2026-nuedc-d-land-air/DS-land-and-air/yolov5/runs/detect/exp6/1.jpeg

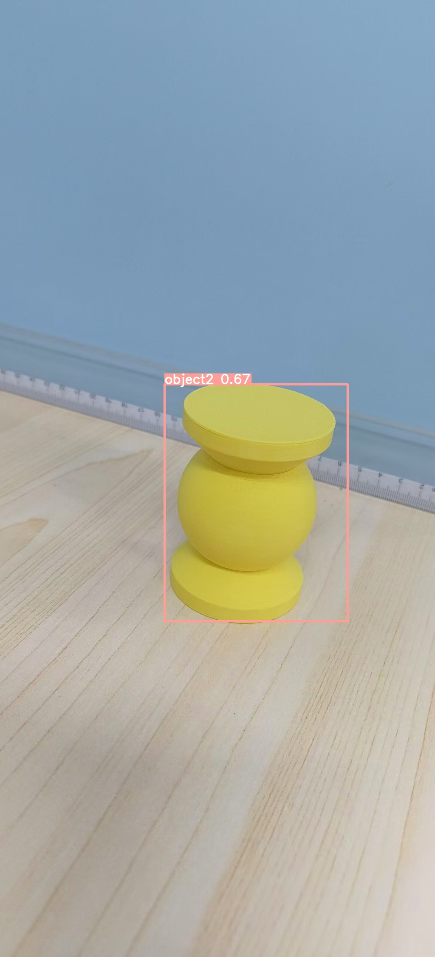
yolov5/runs/detect/exp6/1.jpeg
