2026-nuedc-d-land-air/DS-land-and-air/yolov5/runs/detect/exp12/compare.jpg

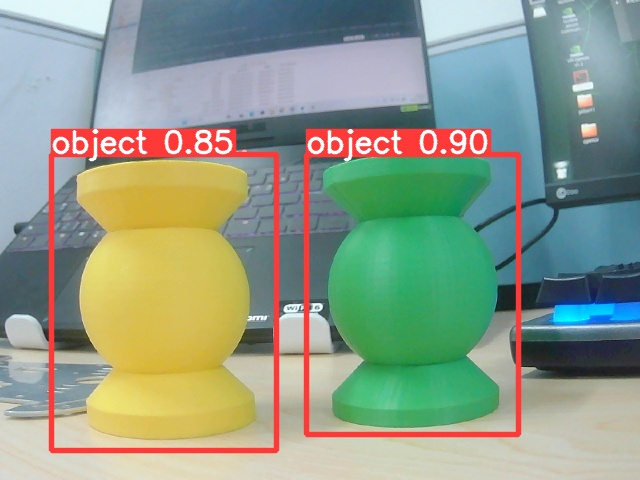
yolov5/runs/detect/exp12/compare.jpg
