2026-nuedc-d-land-air/DS-land-and-air/logs/gray_tracking_sync_20260730.md

# 灰度循迹接口纠正与重新测试检查点（2026-07-30）

## 有效硬件事实

用户提供的实物图确认模块为 Yahboom `YB-MVX05-V1.0`。排针丝印为
`5V / AD2 / AD1 / AD0 / OUT / GND`，并带有 X1--X8 的地址真值表。
模块内置 74HC4051 风格的数据选择器：MCU 输出三位地址，模块在 `OUT` 输出被选中
探头的数字值。蓝光版可用于白底黑线地图。

| 模块信号 | MCU 引脚 | 当前固件方向 |
| --- | --- | --- |
| `AD0` | `PC0` | GPIO 输出，地址 bit0 |
| `AD1` | `PC1` | GPIO 输出，地址 bit1 |
| `AD2` | `PC2` | GPIO 输出，地址 bit2 |
| `OUT` | `PG0` | GPIO 输入，所选头数字输出 |

地址 `000`--`111` 依次选择 X1--X8；固件将八个输出汇成 `raw_mask` 的 bit0--bit7。
以“所有探头都在白底”时的 `all_white_mask` 为基准，`active_mask = raw_mask XOR
all_white_mask`，因此不需要假定模块输出高/低代表黑线。

## 已废止的错误解释

此前将 `PC0/PC1/PC2` 配置成 ADC 输入是错误驱动。于是旧日志的 `adc0/adc1/adc2` 是
地址脚浮空/偏置读数，不是 X1--X8 的反射强度；其 x1/x2/x3 判定和任何 ADC 阈值均
不能用于循迹 PID。原始日志保留，仅作问题定位证据。

## 已完成的软件修正

- `bsp_gray_tracking.*`：改为 AD0/AD1/AD2 地址扫描 + PG0 数字读取；不用 `Delay_us()`
  破坏 SysTick 时间基。
- `app_gray_tracking_test.c`：输出 `raw_mask`、相对白底的 `active_mask` 与去抖
  `stable_mask`。
- `scripts/analyze_gray_mux_log.ps1`：输出逐头 `CHANNEL_SWITCH` 判定。
- `GrayTrackingDebug` 构建通过：FLASH `6400 B / 512 KB`，RAM `2008 B / 64 KB`；
  入口仍先调用 `MotorSafe_InitOff()`，前后 TB6612 关闭。

## 2026-07-30 mux8 全通道实机验收（完成）

已烧录安全的 `GrayTrackingDebug`（启动时仍执行 `MotorSafe_InitOff()`），通过 J-Link
CDC `COM13` 采集：`logs/gray_mux_retest_20260730-104601.log`。

- 全部探头白底、发送 `W` 后：`all_white_mask=0x00`；
- X1--X8 依次从白底移到黑线后，分析器均报告 `CHANNEL_SWITCH`；
- 一一对应关系为：`X1=0x01`、`X2=0x02`、`X3=0x04`、`X4=0x08`、
  `X5=0x10`、`X6=0x20`、`X7=0x40`、`X8=0x80`；
- X3 额外复测的黑线样本为 `0x04`，未出现 X4 的 `0x08`，未观察到相邻头串扰。

结论：`PC0/PC1/PC2 -> AD0/AD1/AD2`、`PG0 <- OUT`、X1--X8 地址顺序和蓝光模块的
白底黑线分辨能力均已实机确认。此前 ADC 记录仍只保留为错误定位归档。

## A 点全黑区域实测（2026-07-30 11:03）

用户确认当前整组探头位于 A 点（起点）的全黑区域。串口命令 `K` 采集黑色快照，日志
为 `logs/gray_mux_all_black_A_20260730-110324.log`：

- `cal_black`：`raw_mask=255`、`active_mask=255`、`stable_mask=255`；
- 随后约 4 s 连续 `sample` 均保持上述 `0xFF` 状态；
- 白底基准仍为 `0x00`，未被本次 `K` 命令改写。

全黑 A 点可以作为后续路线状态机的“位置确认”候选条件；根据当前任务规则，正式任务
启动仍必须由车上实体按键发起，不能由灰度全黑自动启动。

## 正常黑线居中零点实测（2026-07-30 11:06）

用户确认正常黑线居中时 X4 与 X5 同时触发。串口采集
`logs/gray_mux_center_x4_x5_20260730-110625.log` 中 24 条有效样本均为：

```text
raw_mask=24, active_mask=24, stable_mask=24   # 0x18 = X4 | X5
```

`0x18` 现作为灰度横向误差的零点掩码。该记录只证明“阵列索引居中”；尚未定义相对
车体左/右的误差正负，也尚未接入电机控制。

## 车体左/右误差符号实测（2026-07-30 11:15--11:16）

保持车头朝向后，用户按要求将正常黑线相对阵列从中心分别移向车体左、右侧：

| 位置 | 稳定掩码 | 样本 | 证据 |
| --- | --- | --- | --- |
| 车体左偏 | `0x08`（仅 X4） | 23/23 | `gray_mux_vehicle_left_x4_20260730-111544.log` |
| 居中 | `0x18`（X4+X5） | 24/24 | `gray_mux_center_x4_x5_20260730-110625.log` |
| 车体右偏 | `0x10`（仅 X5） | 23/23 | `gray_mux_vehicle_right_x5_20260730-111651.log` |

这确认 X1--X8 的阵列索引从车体左到右递增。安全诊断权重为
`-7/-5/-3/-1/+1/+3/+5/+7`；`err_x100` 的负值表示黑线在车体左，正值表示黑线在车体右。
仅灰度诊断输出允许使用此结论；还没有把误差接到任何电机输出。

## 误差诊断镜像烧录与串口回归（2026-07-30 11:19）

`GrayTrackingDebug` 已构建并通过 J-Link 烧录、逐段比较和复位运行：FLASH `7140 B /
512 KB`，RAM `2008 B / 64 KB`。`COM13` 回归日志
`logs/gray_error_diag_boot_20260730-111933.log` 已确认新字段输出：

```text
line_class,UNCAL,line_side,N/A,active_count,0,err_x100,0
```

烧录复位会清空 RAM 中的 `all_white_mask`，因此这条 `UNCAL` 记录是预期安全状态，
不是传感器故障。下一步必须先让八头同时位于白底并发送 `W`；校准后才可记录有效的
`LINE / LOST / A_MARK`、`line_side` 和 `err_x100`。电机保持关闭。

## 误差诊断三点回归（2026-07-30 11:20--11:22，完成）

新镜像复位后重新标定白底：`gray_error_diag_white_cal_20260730-112045.log`，
`all_white_mask=0x00`、`cal=1`。随后在同一白底基准下完成三点回归：

| 物理位置 | 实测稳定掩码 | 诊断输出 | 证据 |
| --- | --- | --- | --- |
| 正常居中 | `0x18`（X4+X5） | `LINE, CENTER, err_x100=0` | `gray_error_diag_center_20260730-112143.log` |
| 黑线在车体左 | `0x08`（X4） | `LINE, VEH_LEFT, err_x100=-100` | `gray_error_diag_vehicle_left_x4_20260730-112215.log` |
| 黑线在车体右 | `0x10`（X5） | `LINE, VEH_RIGHT, err_x100=100` | `gray_error_diag_vehicle_right_x5_20260730-112247.log` |

三组样本均持续约 4 s、无掩码跳变，证明 mux8 采样、3 次去抖、权重、中心零点和左右
符号在当前地图上闭合一致。允许把 `err_x100` 接入下一阶段的“仅计算控制量”循迹外环；
电机驱动输出仍必须保持断开，直到单独完成方向、限幅和失线保护测试。

## 后续受控步骤

1. 保持电机关闭，以实际安装朝向确认 X1--X8 的车体左/右方向，并把 `active_mask`
   转换为加权横向误差。
2. 先只输出误差、丢线和交叉线判定日志；确认误差正负后才接入低速循迹控制。
3. 速度闭环、陀螺仪修正和灰度外环必须按阶段叠加，不能跳过电机方向与误差符号验收。
