2026-nuedc-d-land-air/DS-land-and-air/yolov5/runs/detect/exp6/0.jpeg

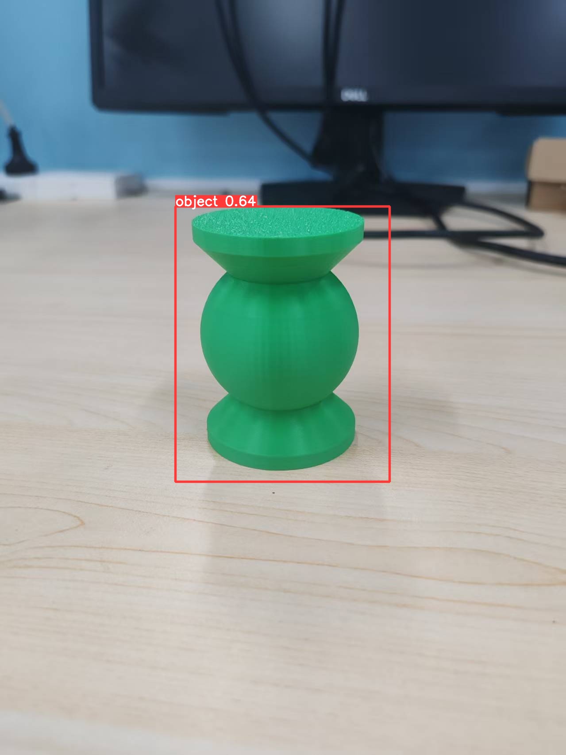
yolov5/runs/detect/exp6/0.jpeg
