2026-nuedc-d-land-air/DS-land-and-air/双臂小车/机械臂/爪子/爪子.SLDASM

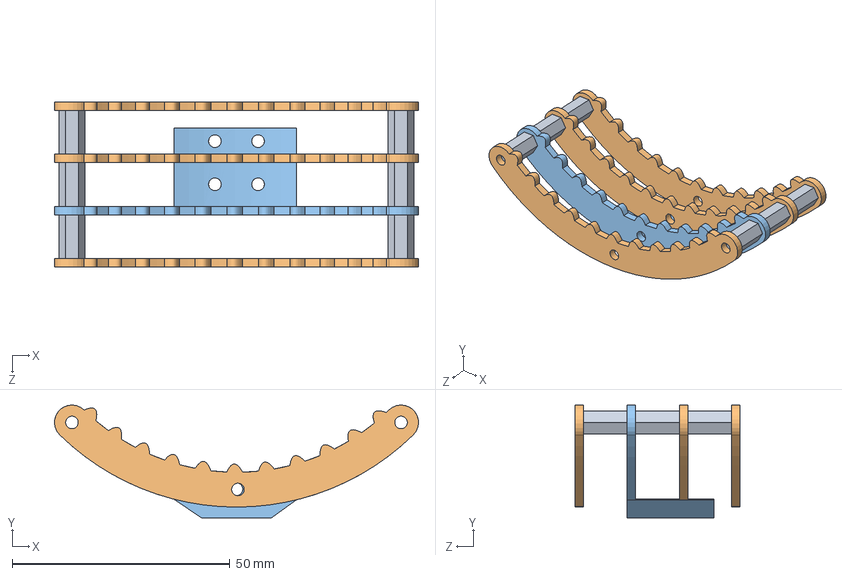
[picture p4: CAD file, 2026-07-15]
双臂小车/机械臂/爪子/爪子.SLDASM
83.6 x 25.9 x 38.0 mm
爪片连接
爪片 x 3
10mm铜柱 x 6
