2026-nuedc-d-land-air/DS-land-and-air/双臂小车/小车/小车基础模型.SLDASM

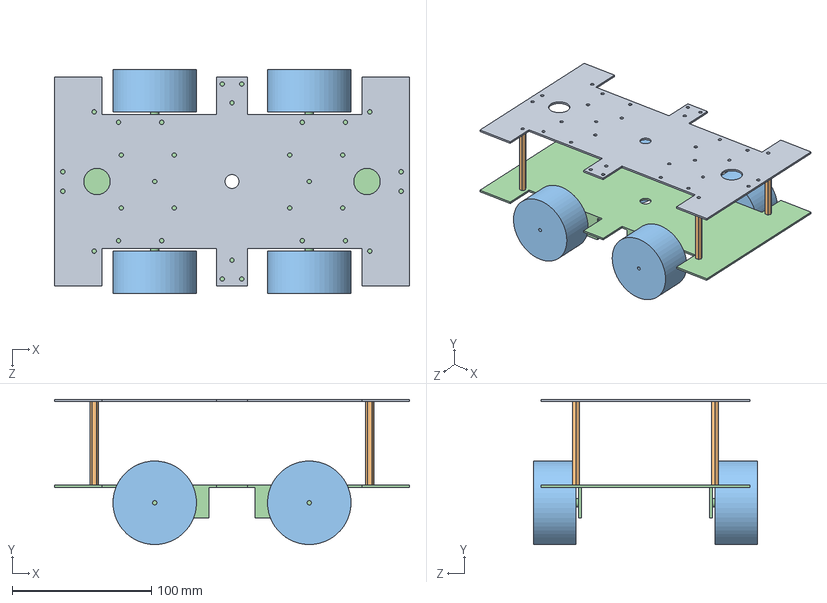
[picture p5: CAD file, 2026-07-15]
双臂小车/小车/小车基础模型.SLDASM
255.0 x 104.2 x 161.2 mm
小车下底板
仿车轮尺寸 x 4
60mm铜柱 x 4
小车上底板
