2026-nuedc-d-land-air/DS-land-and-air/双臂小车/小车/仿车轮尺寸.SLDPRT

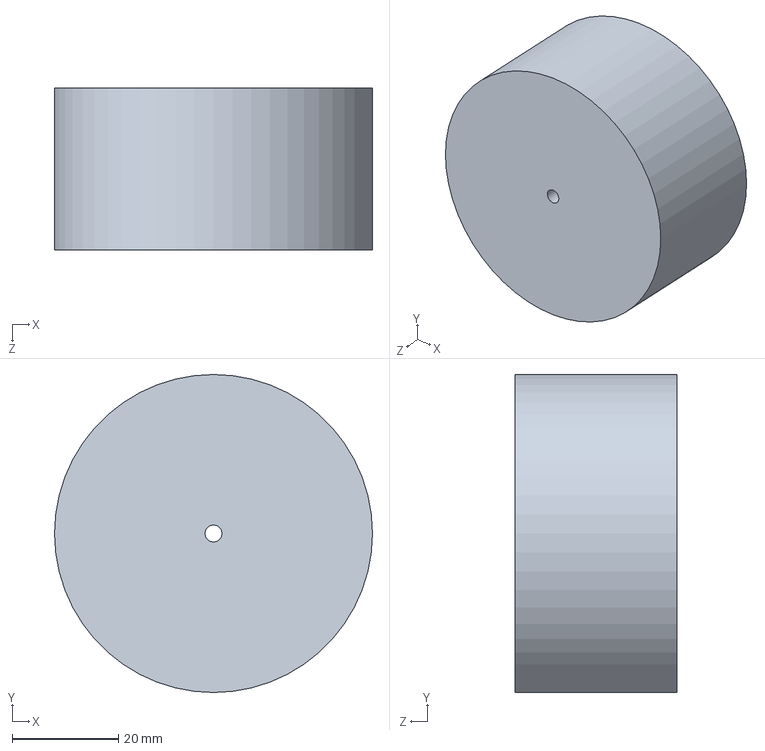
[picture p6: CAD file, 2026-07-15]
双臂小车/小车/仿车轮尺寸.SLDPRT
60.0 x 60.0 x 30.6 mm
