2026-nuedc-d-land-air/DS-land-and-air/双臂小车/开发板固定架等/Jason固定架.SLDPRT

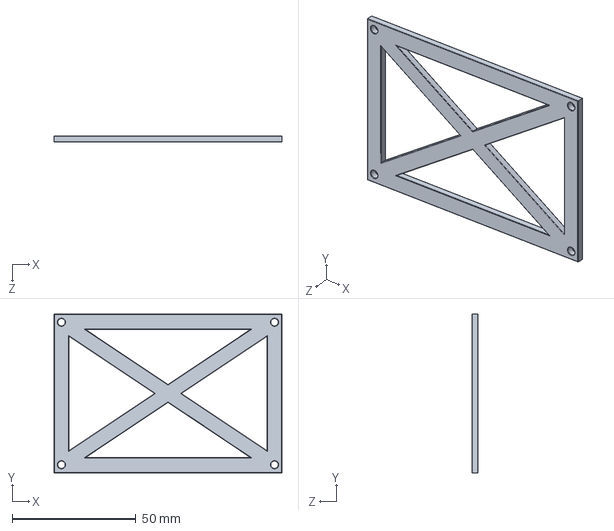
[picture p7: CAD file, 2026-07-15]
双臂小车/开发板固定架等/Jason固定架.SLDPRT
92.0 x 64.0 x 2.60 mm
