2026-nuedc-d-land-air/DS-land-and-air/双臂小车/机械臂/STL文件/舵盘.STL

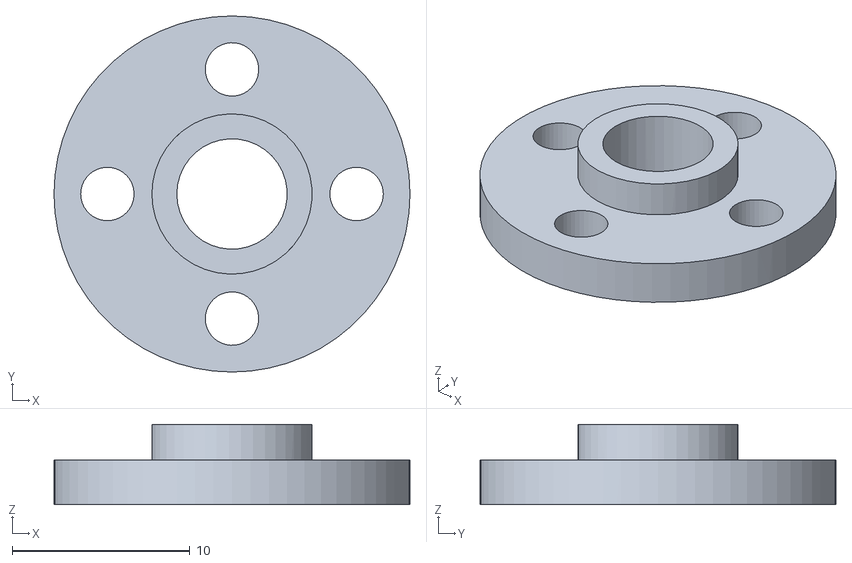
[picture p8: CAD file, 2026-07-15]
双臂小车/机械臂/STL文件/舵盘.STL
20.0 x 20.0 x 4.50
