2026-nuedc-d-land-air/DS-land-and-air/双臂小车/机械臂/固定架.SLDPRT

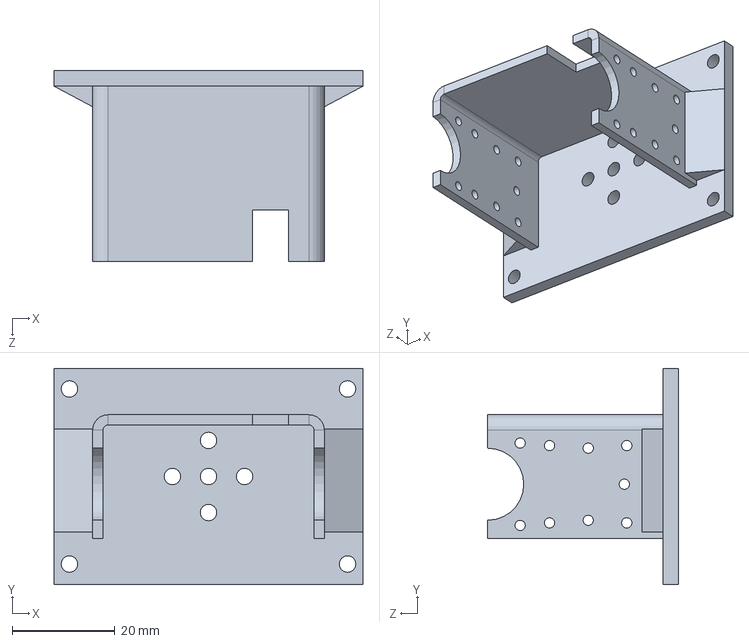
[picture p9: CAD file, 2026-07-15]
双臂小车/机械臂/固定架.SLDPRT
60.0 x 42.0 x 37.0 mm
