2026-nuedc-d-land-air/DS-land-and-air/双臂小车/机械臂/爪子/10mm铜柱.SLDPRT

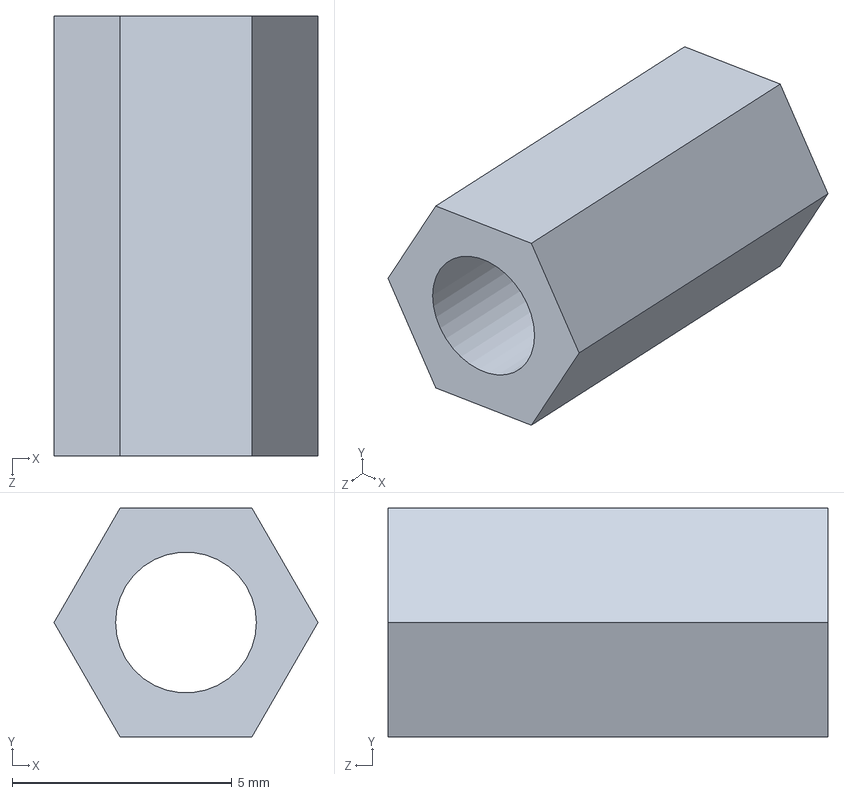
[picture p10: CAD file, 2026-07-15]
双臂小车/机械臂/爪子/10mm铜柱.SLDPRT
6.00 x 5.20 x 10.0 mm
