2026-nuedc-d-land-air/DS-land-and-air/双臂小车/小车/60mm铜柱.SLDPRT

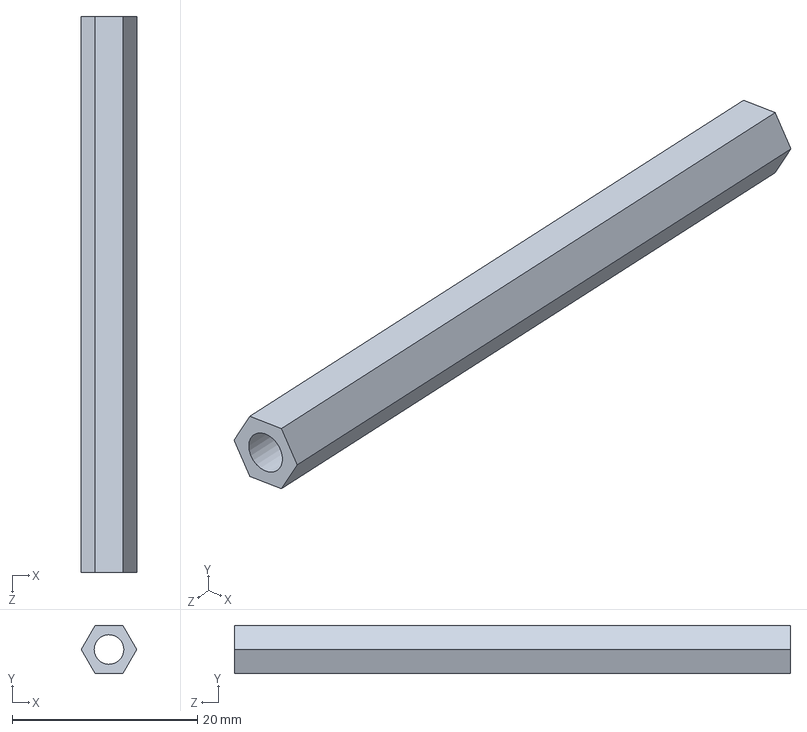
[picture p11: CAD file, 2026-07-15]
双臂小车/小车/60mm铜柱.SLDPRT
6.00 x 5.20 x 60.0 mm
