2026-nuedc-d-land-air/DS-land-and-air/双臂小车/开发板固定架等/工创棋子.SLDPRT

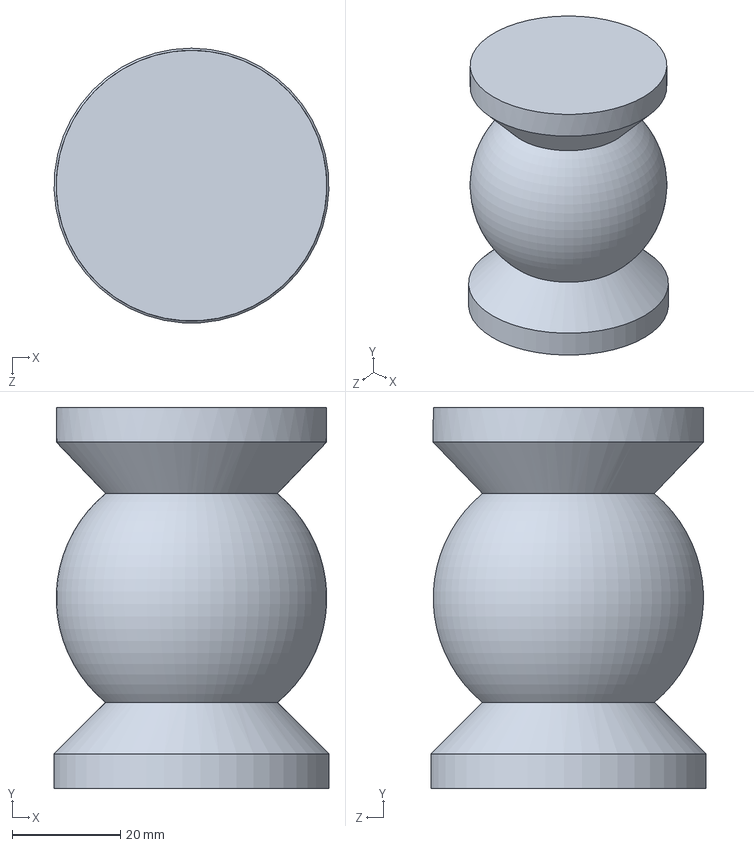
[picture p12: CAD file, 2026-07-15]
双臂小车/开发板固定架等/工创棋子.SLDPRT
50.8 x 70.4 x 50.7 mm
