2026-nuedc-d-land-air/DS-land-and-air/双臂小车/机械臂/STL文件/爪片连接.STL

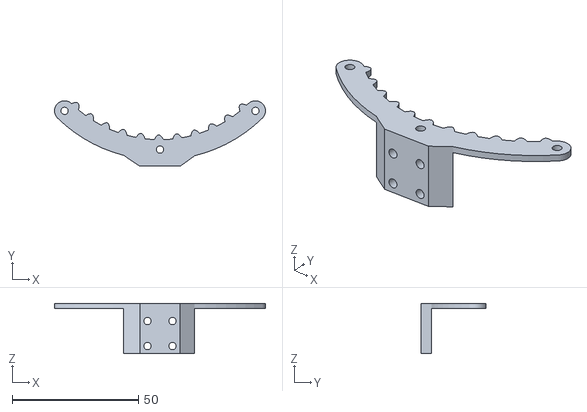
[picture p13: CAD file, 2026-07-15]
双臂小车/机械臂/STL文件/爪片连接.STL
83.6 x 25.9 x 20.0
