2026-nuedc-d-land-air/DS-land-and-air/双臂小车/机械臂/手臂肩关节.SLDPRT

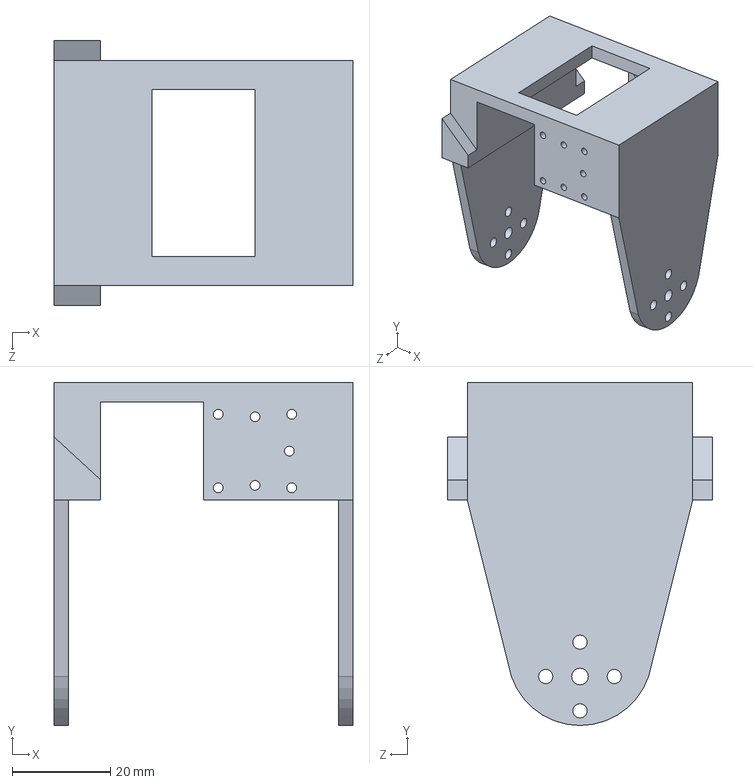
[picture p14: CAD file, 2026-07-15]
双臂小车/机械臂/手臂肩关节.SLDPRT
61.0 x 70.0 x 54.0 mm
