2026-nuedc-d-land-air/DS-land-and-air/双臂小车/小车/小车下底板.SLDPRT

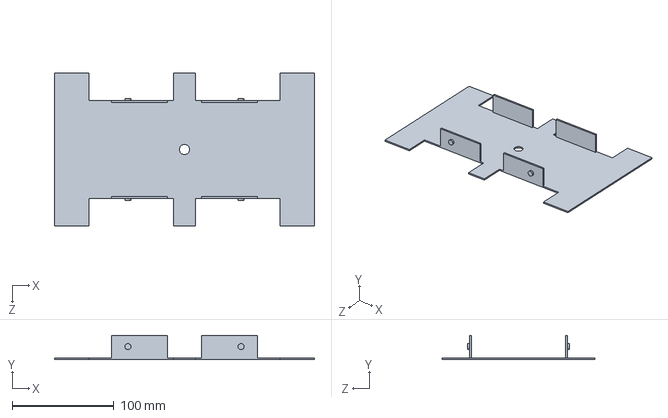
[picture p15: CAD file, 2026-07-15]
双臂小车/小车/小车下底板.SLDPRT
255.0 x 23.6 x 150.0 mm
