2026-nuedc-d-land-air/DS-land-and-air/双臂小车/机械臂/STL文件/大臂连杆.3mf

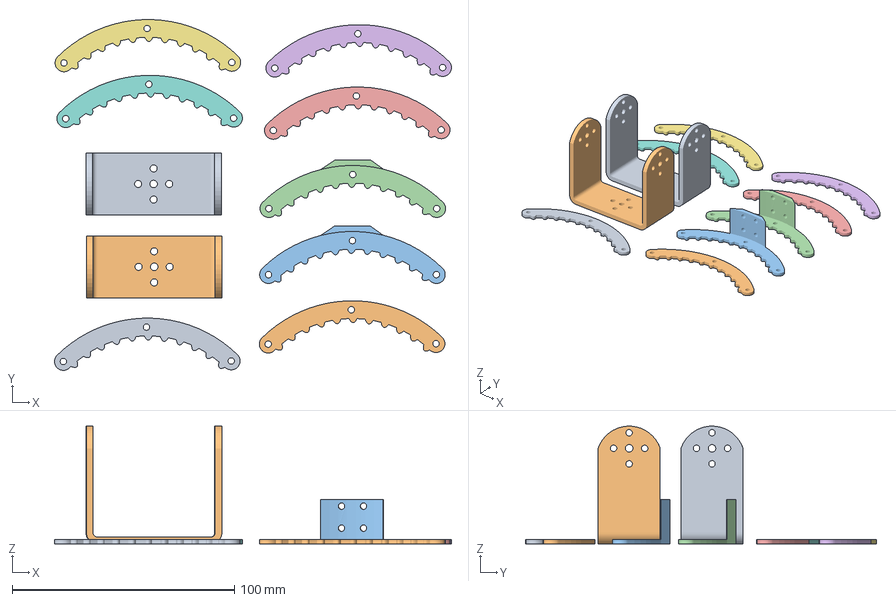
[picture p16: CAD file, 2026-07-15]
双臂小车/机械臂/STL文件/大臂连杆.3mf
178.8 x 158.0 x 53.0 mm
U形支架.STL x 2
爪片连接.STL x 2
爪片.STL x 6
