2026-nuedc-d-land-air/DS-land-and-air/双臂小车/机械臂/夹爪.SLDPRT

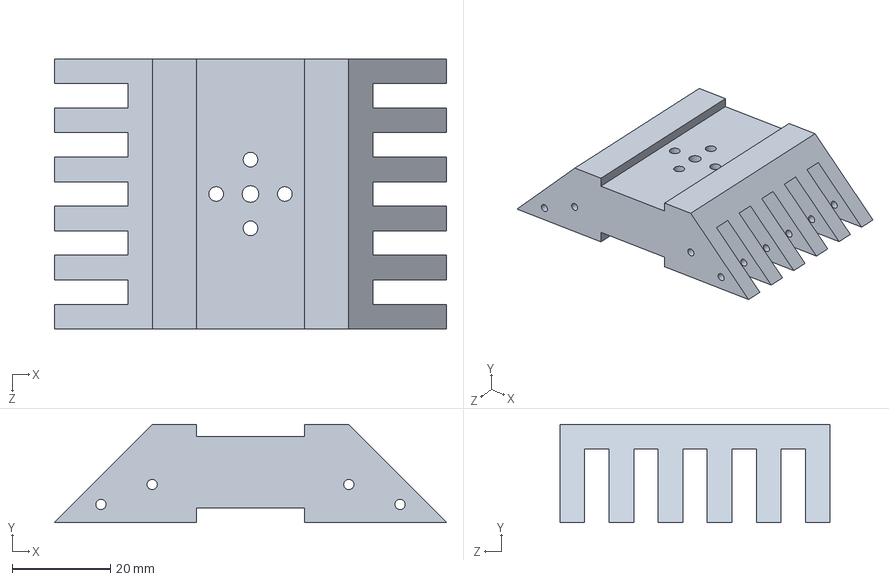
[picture p17: CAD file, 2026-07-15]
双臂小车/机械臂/夹爪.SLDPRT
80.0 x 20.0 x 55.0 mm
