2026-nuedc-d-land-air/DS-land-and-air/双臂小车/机械臂/STL文件/爪片.STL

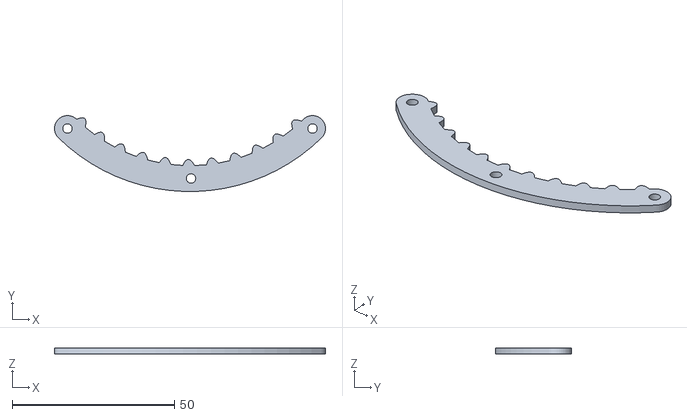
[picture p18: CAD file, 2026-07-15]
双臂小车/机械臂/STL文件/爪片.STL
83.6 x 23.4 x 2.00
