2026-nuedc-d-land-air/DS-land-and-air/双臂小车/机械臂/右肩关节固定架.SLDPRT

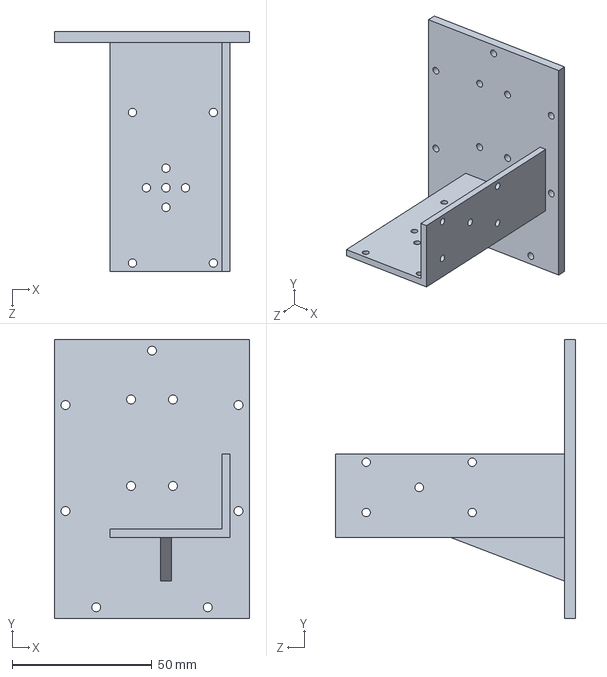
[picture p19: CAD file, 2026-07-15]
双臂小车/机械臂/右肩关节固定架.SLDPRT
70.0 x 100.0 x 86.0 mm
