2026-nuedc-d-land-air/DS-land-and-air/双臂小车/机械臂/肩关节舵机固定.SLDPRT

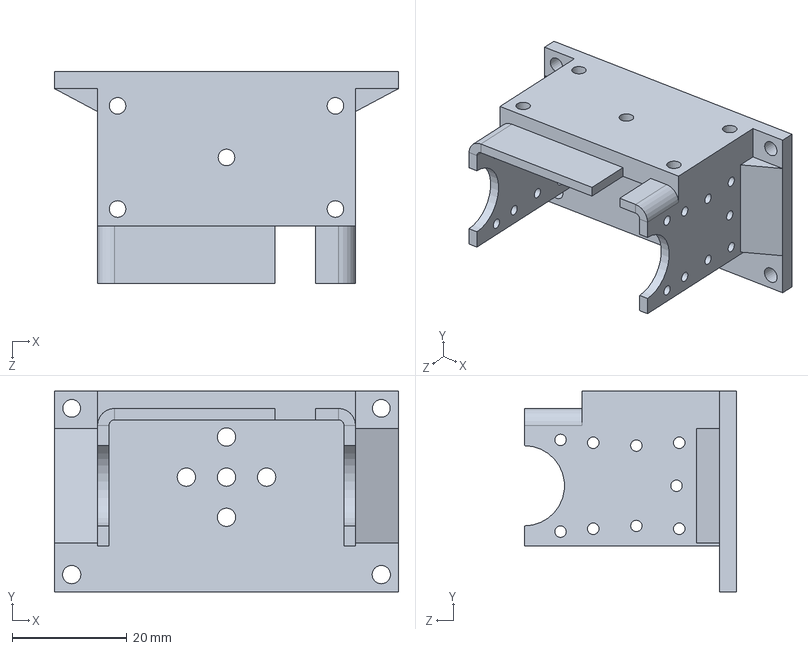
[picture p21: CAD file, 2026-07-15]
双臂小车/机械臂/肩关节舵机固定.SLDPRT
60.0 x 35.0 x 37.0 mm
