2026-nuedc-d-land-air/DS-land-and-air/双臂小车/机械臂/大臂连杆.SLDPRT

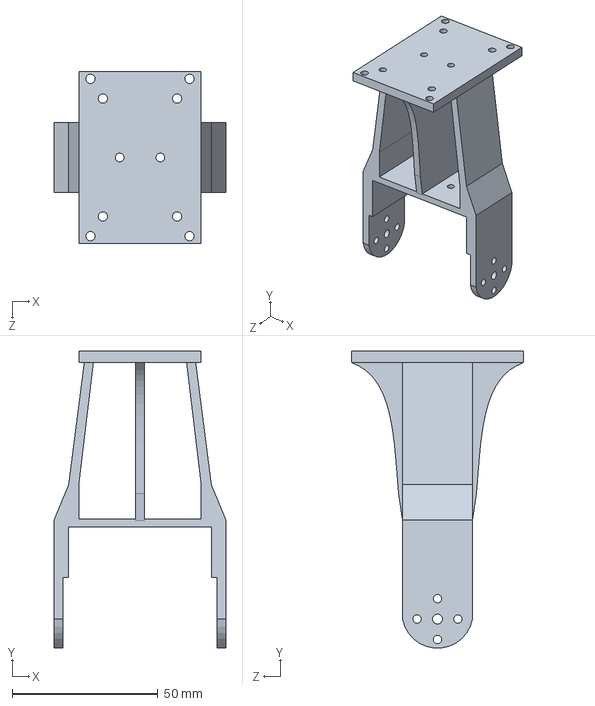
[picture p22: CAD file, 2026-07-15]
双臂小车/机械臂/大臂连杆.SLDPRT
59.0 x 101.9 x 59.0 mm
