2026-nuedc-d-land-air/DS-land-and-air/双臂小车/机械臂/STL文件/U形支架.STL

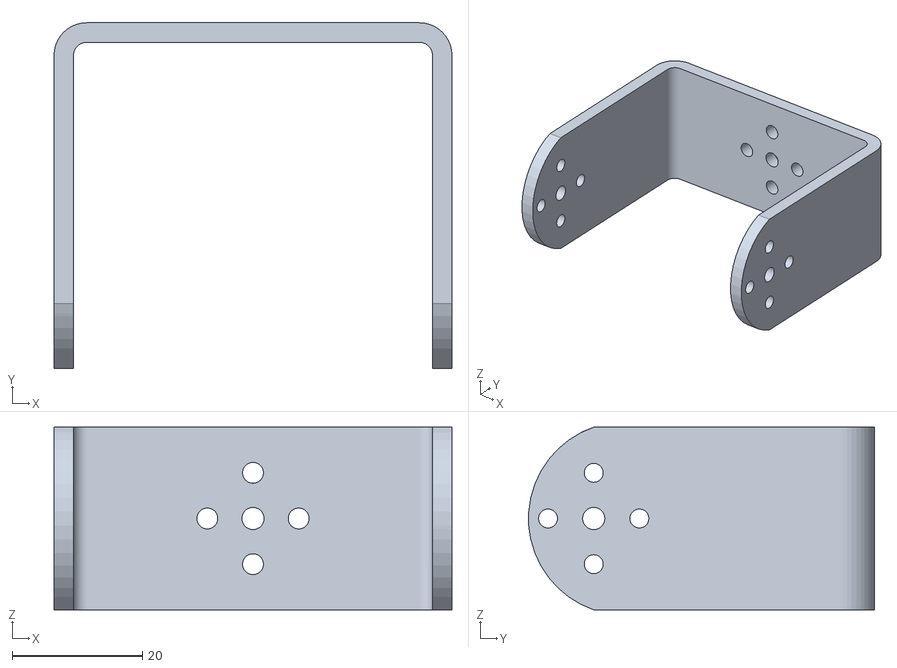
[picture p23: CAD file, 2026-07-15]
双臂小车/机械臂/STL文件/U形支架.STL
61.0 x 53.0 x 28.0
