2026-nuedc-d-land-air/DS-land-and-air/双臂小车/双臂小车.SLDASM

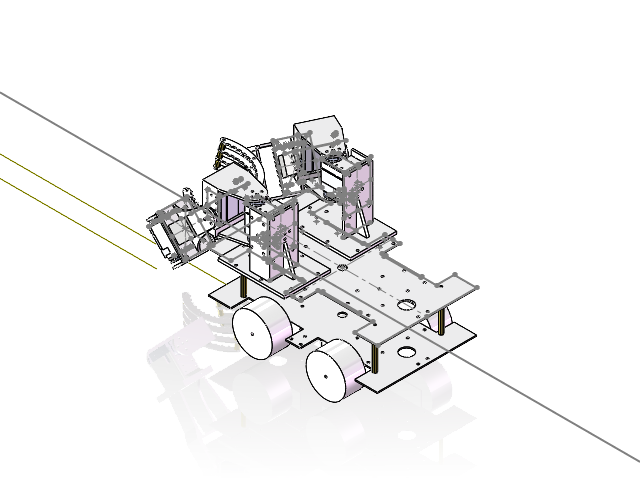
[picture p24: CAD file, 2026-07-15]
双臂小车/双臂小车.SLDASM
小车下底板
仿车轮尺寸 x 4
60mm铜柱 x 4
小车上底板
手臂肩关节 x 2
SG_178.stp x 6
ZK_142.stp x 6
DG_130.stp x 6
GE_57.stp x 6
DUOPAN-SG.stp x 6
DUOPAN-DG.stp x 6
大臂连杆 x 2
固定架 x 2
U形支架 x 2
肩关节舵机固定 x 2
右肩关节固定架
左肩关节固定架
爪片连接 x 2
爪片 x 6
10mm铜柱 x 12
