2026-nuedc-d-land-air/DS-land-and-air/双臂小车/机械臂/肩关节加大臂.SLDASM

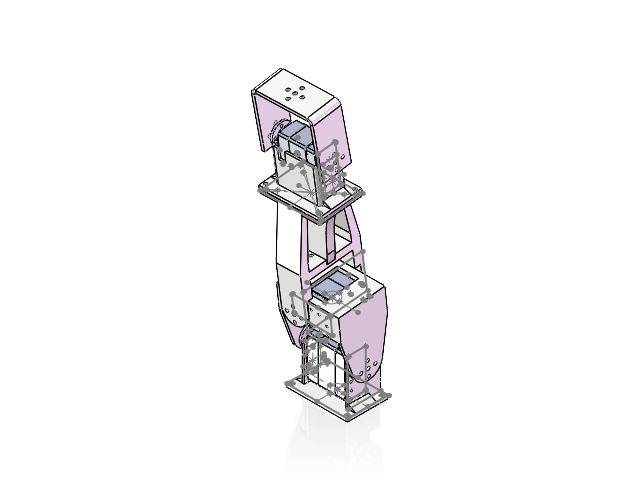
[picture p25: CAD file, 2026-07-15]
双臂小车/机械臂/肩关节加大臂.SLDASM
手臂肩关节
SG_178.stp x 3
ZK_142.stp x 3
DG_130.stp x 3
GE_57.stp x 3
DUOPAN-SG.stp x 3
DUOPAN-DG.stp x 3
大臂连杆
固定架
U形支架
肩关节舵机固定
