2026-nuedc-d-land-air/DS-land-and-air/双臂小车/机械臂/双轴舵机和固定架.SLDASM

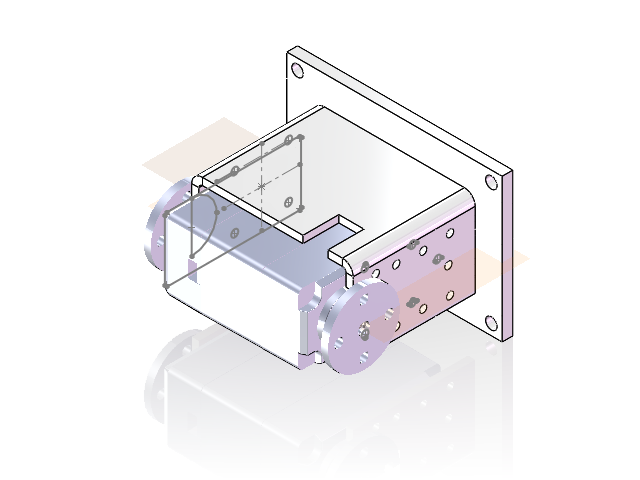
[picture p26: CAD file, 2026-07-15]
双臂小车/机械臂/双轴舵机和固定架.SLDASM
固定架
SG_178.stp
ZK_142.stp
DG_130.stp
GE_57.stp
DUOPAN-SG.stp
DUOPAN-DG.stp
