2026-nuedc-d-land-air/DS-land-and-air/(list of files, cad)

Other CAD files:
双臂小车/机械臂/双轴舵机-260528/双轴舵机-260528.sldasm
双臂小车/机械臂/双轴舵机-260528/双轴舵机-260528/双轴舵机-260528.stp.sldasm
双臂小车/机械臂/双轴舵机-260528/双轴舵机-260528/ZK_142.stp.sldprt
双臂小车/机械臂/双轴舵机-260528/双轴舵机-260528/SG_178.stp.sldprt
双臂小车/机械臂/爪子/爪片连接.SLDPRT
双臂小车/机械臂/双轴舵机-260528/双轴舵机-260528/GE_57.stp.sldprt
双臂小车/机械臂/爪子/爪片.SLDPRT
双臂小车/机械臂/STL文件/左肩关节固定架.STL
双臂小车/机械臂/双轴舵机-260528/双轴舵机-260528/DUOPAN-SG.stp.sldprt
双臂小车/机械臂/STL文件/右肩关节固定架.STL
双臂小车/机械臂/双轴舵机-260528/双轴舵机-260528/DUOPAN-DG.stp.sldprt
双臂小车/机械臂/左肩关节固定架.SLDPRT
双臂小车/机械臂/STL文件/肩关节舵机固定.STL
双臂小车/机械臂/双轴舵机-260528/双轴舵机-260528/DG_130.stp.sldprt
双臂小车/机械臂/U形支架.SLDPRT
双臂小车/机械臂/STL文件/固定架.STL
双臂小车/机械臂/STL文件/手臂肩关节.STL
双臂小车/机械臂/舵盘.SLDPRT
双臂小车/开发板固定架等/Jason固定架.STL
双臂小车/开发板固定架等/工创棋子.STL
双臂小车/机械臂/STL文件/大臂连杆.STL
