2026-nuedc-d-land-air/DS-land-and-air/logs/bluetooth_mecanum_test_template_20260713.csv

run_id | phone_button | rx_hex | rx_ascii | requested_motion | lf_actual | rf_actual | lr_actual | rr_actual | timeout_stop | pass | notes
1 | forward | N/A | N/A | forward | N/A | N/A | N/A | N/A | N/A | N/A
