2026-nuedc-d-land-air/DS-land-and-air/logs/front_test_idr_20260712.csv

# actual_behavior: same as first run; LF forward once; RF intermittent forward twice
# conclusion: PE11 and PE12 cannot rise at the MCU pad; PC7 cannot fall at the MCU pad
seq | time_ms | event | wheel | cmd | pe_odr | pc_odr | pe_idr | pc_idr | tim5_ccr1 | tim5_ccr2 | tim3_ccr1 | tim3_ccr2
0 | 0 | 2 | 255 | 0 | 0x0000 | 0x0000 | 0x6003 | 0x2FBE | 0 | 0 | 0 | 0
1 | 0 | 1 | 255 | 0 | 0x0000 | 0x0000 | 0x6003 | 0x2FBE | 0 | 0 | 0 | 0
2 | 1000 | 3 | 0 | 60 | 0x0400 | 0x0000 | 0x6403 | 0x2FBE | 2160 | 0 | 0 | 0
3 | 2500 | 4 | 0 | 0 | 0x0000 | 0x0000 | 0x6003 | 0x2FBE | 0 | 0 | 0 | 0
4 | 3500 | 3 | 0 | -60 | 0x0800 | 0x0000 | 0x6003 | 0x2FBE | 2160 | 0 | 0 | 0
5 | 5000 | 4 | 0 | 0 | 0x0000 | 0x0000 | 0x6003 | 0x2FBE | 0 | 0 | 0 | 0
6 | 7000 | 3 | 1 | 60 | 0x1000 | 0x0000 | 0x6003 | 0x2FBE | 0 | 2160 | 0 | 0
7 | 8500 | 4 | 1 | 0 | 0x0000 | 0x0000 | 0x6043 | 0x2FBE | 0 | 0 | 0 | 0
8 | 9500 | 3 | 1 | -60 | 0x0000 | 0x0080 | 0x6043 | 0x2FBE | 0 | 2160 | 0 | 0
9 | 11000 | 4 | 1 | 0 | 0x0000 | 0x0000 | 0x6043 | 0x2FBE | 0 | 0 | 0 | 0
10 | 13000 | 1 | 255 | 0 | 0x0000 | 0x0000 | 0x6043 | 0x2FBE | 0 | 0 | 0 | 0
