2026-nuedc-d-land-air/DS-land-and-air/Hardware/bsp_usart.c

#include "AllHeader.h"
#include <string.h>



//USART1 ---- PCͨţϢ  USART1 ---- Communicates with PC, outputs debug information
void USART1_init(u32 baudrate)
{
	GPIO_InitTypeDef GPIO_InitStructure;
	USART_InitTypeDef USART_InitStructure;
	NVIC_InitTypeDef NVIC_InitStructure; 
	
	RCC_APB2PeriphClockCmd(RCC_APB2Periph_USART1 | RCC_APB2Periph_GPIOA, ENABLE);
	
	GPIO_InitStructure.GPIO_Pin = GPIO_Pin_9;
	GPIO_InitStructure.GPIO_Mode = GPIO_Mode_AF_PP;
	GPIO_InitStructure.GPIO_Speed = GPIO_Speed_50MHz;
	GPIO_Init(GPIOA, &GPIO_InitStructure);    

	GPIO_InitStructure.GPIO_Pin = GPIO_Pin_10;
	GPIO_InitStructure.GPIO_Mode = GPIO_Mode_IN_FLOATING;
	GPIO_Init(GPIOA, &GPIO_InitStructure);
	  
	USART_InitStructure.USART_BaudRate = baudrate;
	USART_InitStructure.USART_WordLength = USART_WordLength_8b;
	USART_InitStructure.USART_StopBits = USART_StopBits_1;
	USART_InitStructure.USART_Parity = USART_Parity_No ;
	USART_InitStructure.USART_HardwareFlowControl = USART_HardwareFlowControl_None;
	USART_InitStructure.USART_Mode = USART_Mode_Rx | USART_Mode_Tx;
	USART_Init(USART1, &USART_InitStructure); 
	USART_ITConfig(USART1, USART_IT_TXE, DISABLE);  
	USART_ITConfig(USART1, USART_IT_RXNE, ENABLE); //ж   Enable receive interrupt
	USART_ClearFlag(USART1,USART_FLAG_TC);
	USART_Cmd(USART1, ENABLE);
	
	
	NVIC_InitStructure.NVIC_IRQChannel = USART1_IRQn;
	NVIC_InitStructure.NVIC_IRQChannelPreemptionPriority = 1;
	NVIC_InitStructure.NVIC_IRQChannelSubPriority = 3;
	NVIC_InitStructure.NVIC_IRQChannelCmd = ENABLE;
	NVIC_Init(&NVIC_InitStructure);

}

/**
 * @Brief: UART1    UART1 sends data
 * @Note: 
 * @Parm: ch:͵     ch:data to be sent 
 * @Retval: 
 */
void USART1_Send_U8(uint8_t ch)
{
	while (USART_GetFlagStatus(USART1, USART_FLAG_TXE) == RESET)
		;
	USART_SendData(USART1, ch);
}

/**
 * @Brief: UART1    UART1 sends data
 * @Note: 
 * @Parm: BufferPtr:͵  Length:ݳ BufferPtr:data to be sent Length:data length
 * @Retval: 
 */
void USART1_Send_ArrayU8(uint8_t *BufferPtr, uint16_t Length)
{
	while (Length--)
	{
		USART1_Send_U8(*BufferPtr);
		BufferPtr++;
	}
}

//жϷ  Serial port interrupt service function
void USART1_IRQHandler(void)
{
	uint8_t Rx1_Temp = 0;
	if (USART_GetITStatus(USART1, USART_IT_RXNE) != RESET)
	{
		Rx1_Temp = USART_ReceiveData(USART1);
		USART1_Send_U8(Rx1_Temp);
	}
}

///ضc⺯printfڣضʹprintf Redirect the c library function printf to the serial port, after redirection you can use the printf function
int fputc(int ch, FILE *f)
{
	/*һֽݵ */   /* Send a byte of data to the serial port */
	USART_SendData(DEBUG_USARTx, (uint8_t)ch);

	/* ȴ */    /* Waiting for transmission completion */
	while (USART_GetFlagStatus(DEBUG_USARTx, USART_FLAG_TXE) == RESET)
		;
	return (ch);
}

///ضc⺯scanfڣдʹscanfgetcharȺ  Redirect the c library function scanf to the serial port, rewrite backward to use scanf, getchar and other functions
int fgetc(FILE *f)
{
	/* ȴ */  /* Waiting for data input from serial port */
	while (USART_GetFlagStatus(DEBUG_USARTx, USART_FLAG_RXNE) == RESET)
		;
	return (int)USART_ReceiveData(DEBUG_USARTx);
}


//USART2
void USART2_init(u32 baudrate)
{
	GPIO_InitTypeDef GPIO_InitStructure;
	USART_InitTypeDef USART_InitStructure;
	NVIC_InitTypeDef NVIC_InitStructure; 
	
	
	RCC_APB1PeriphClockCmd(RCC_APB1Periph_USART2, ENABLE);
	RCC_APB2PeriphClockCmd(RCC_APB2Periph_GPIOA , ENABLE);
	
	
	GPIO_InitStructure.GPIO_Pin = GPIO_Pin_2;//TX
	GPIO_InitStructure.GPIO_Mode = GPIO_Mode_AF_PP;
	GPIO_InitStructure.GPIO_Speed = GPIO_Speed_50MHz;
	GPIO_Init(GPIOA, &GPIO_InitStructure);    

	GPIO_InitStructure.GPIO_Pin = GPIO_Pin_3;//RX
	GPIO_InitStructure.GPIO_Mode = GPIO_Mode_IN_FLOATING;
	GPIO_Init(GPIOA, &GPIO_InitStructure);
	
	NVIC_InitStructure.NVIC_IRQChannel = USART2_IRQn;
	NVIC_InitStructure.NVIC_IRQChannelPreemptionPriority = 1;
	NVIC_InitStructure.NVIC_IRQChannelSubPriority = 1;
	NVIC_InitStructure.NVIC_IRQChannelCmd = ENABLE;
	NVIC_Init(&NVIC_InitStructure);
	  
	USART_InitStructure.USART_BaudRate = baudrate;
	USART_InitStructure.USART_WordLength = USART_WordLength_8b;
	USART_InitStructure.USART_StopBits = USART_StopBits_1;
	USART_InitStructure.USART_Parity = USART_Parity_No ;
	USART_InitStructure.USART_HardwareFlowControl = USART_HardwareFlowControl_None;
	USART_InitStructure.USART_Mode = USART_Mode_Rx | USART_Mode_Tx;
	USART_Init(USART2, &USART_InitStructure); 
 
	USART_ITConfig(USART2, USART_IT_RXNE, ENABLE);        
	//USART_ClearFlag(USART2,USART_FLAG_TC);
	USART_Cmd(USART2, ENABLE);

}

//һַ    Send a character
void USART2_Send_U8(uint8_t ch)
{
	while (USART_GetFlagStatus(USART2, USART_FLAG_TXE) == RESET)
		;
	USART_SendData(USART2, ch);
}

//һַ   Send a character
/**
 * @Brief: UsART2    UsART2 sends data
 * @Note: 
 * @Parm: BufferPtr:͵  Length:ݳ BufferPtr:data to be sent Length:data length
 * @Retval: 
 */
void USART2_Send_ArrayU8(uint8_t *BufferPtr, uint16_t Length)
{
	while (Length--)
	{
		USART2_Send_U8(*BufferPtr);
		BufferPtr++;
	}
}

//жϷ  Serial port interrupt service function
void USART2_IRQHandler(void)
{
	uint8_t Rx2_Temp;
	if (USART_GetITStatus(USART2, USART_IT_RXNE) != RESET)
	{
		USART_ClearITPendingBit(USART2, USART_IT_RXNE);
		Rx2_Temp = USART_ReceiveData(USART2);
		Deal_IR_Usart(Rx2_Temp);//  Processing data
		//USART2_Send_U8(Rx2_Temp); //ֻշ Sending and Receiving Tests Only

	}
}

/*====================================================================================*/
/*                                   UART4 (PC10/PC11)                                */
/*====================================================================================*/
/* 用于日志导出（DAPLink），仅实现最小化的阻塞发送 */
void UART4_init(u32 baudrate)
{
	GPIO_InitTypeDef GPIO_InitStructure;
	USART_InitTypeDef USART_InitStructure;

	/* UART4 时钟(APB1) + GPIOC 时钟(APB2) */
	RCC_APB1PeriphClockCmd(RCC_APB1Periph_UART4, ENABLE);
	RCC_APB2PeriphClockCmd(RCC_APB2Periph_GPIOC | RCC_APB2Periph_AFIO, ENABLE);

	/* PC10 = TX */
	GPIO_InitStructure.GPIO_Pin = GPIO_Pin_10;
	GPIO_InitStructure.GPIO_Mode = GPIO_Mode_AF_PP;
	GPIO_InitStructure.GPIO_Speed = GPIO_Speed_50MHz;
	GPIO_Init(GPIOC, &GPIO_InitStructure);

	/* PC11 = RX */
	GPIO_InitStructure.GPIO_Pin = GPIO_Pin_11;
	GPIO_InitStructure.GPIO_Mode = GPIO_Mode_IN_FLOATING;
	GPIO_Init(GPIOC, &GPIO_InitStructure);

	USART_InitStructure.USART_BaudRate = baudrate;
	USART_InitStructure.USART_WordLength = USART_WordLength_8b;
	USART_InitStructure.USART_StopBits = USART_StopBits_1;
	USART_InitStructure.USART_Parity = USART_Parity_No;
	USART_InitStructure.USART_HardwareFlowControl = USART_HardwareFlowControl_None;
	USART_InitStructure.USART_Mode = USART_Mode_Rx | USART_Mode_Tx;
	USART_Init(UART4, &USART_InitStructure);

	USART_Cmd(UART4, ENABLE);
}

void UART4_Send_U8(uint8_t ch)
{
	while (USART_GetFlagStatus(UART4, USART_FLAG_TXE) == RESET) {
		;
	}
	USART_SendData(UART4, ch);
}

void UART4_Send_ArrayU8(uint8_t *BufferPtr, uint16_t Length)
{
	while (Length--) {
		UART4_Send_U8(*BufferPtr);
		BufferPtr++;
	}
}

void UART4_Send_String(const char *str)
{
	if (str == 0) return;
	UART4_Send_ArrayU8((uint8_t *)str, (uint16_t)strlen(str));
}
