2026-nuedc-d-land-air/DS-land-and-air/Hardware/IOI2C.c

#include "IOI2C.h"
#include "delay.h"
#include "stm32f10x_gpio.h"
#include "stm32f10x_rcc.h"

void Delay(u32 count)//400KHzIIC
{
	unsigned int uiCnt = count*8;
	while (uiCnt --);
}
void IIC_Init(void)
{			
	GPIO_InitTypeDef GPIO_InitStructure;
 	RCC_APB2PeriphClockCmd(RCC_APB2Periph_GPIOB, ENABLE);		
 	GPIO_InitStructure.GPIO_Pin = GPIO_Pin_10 | GPIO_Pin_11;	
	GPIO_InitStructure.GPIO_Mode = GPIO_Mode_Out_PP;       
	GPIO_InitStructure.GPIO_Speed = GPIO_Speed_50MHz;
	GPIO_Init(GPIOB, &GPIO_InitStructure);
	
	SDA_OUT();     
	IIC_SDA=1;	  	  
	IIC_SCL=1;
}

void IIC_Start(void)
{
	SDA_OUT();    
	IIC_SDA=1;	  	  
	IIC_SCL=1;
	
	Delay(5);
 	IIC_SDA=0;//START:when CLK is high,DATA change form high to low 
	
	Delay(5);
	IIC_SCL=0;
}
	  
void IIC_Stop(void)
{
	SDA_OUT();
	IIC_SCL=0;
	IIC_SDA=0;//STOP:when CLK is high DATA change form low to high
 	
		Delay(5);
	IIC_SCL=1; 
	IIC_SDA=1;
	
		Delay(5);							   	
}

u8 IIC_Wait_Ack(void)
{
	u8 ucErrTime=0; 
	SDA_IN();     
	IIC_SDA=1;
		Delay(5);	  
	while(READ_SDA)
	{
		ucErrTime++;
		if(ucErrTime>50)
		{
			IIC_Stop();
			return 1;
		}
		Delay(5);
	}  
	IIC_SCL=1;
	Delay(5); 
	IIC_SCL=0;
	return 0;  
} 

void IIC_Ack(void)
{
	IIC_SCL=0;
	SDA_OUT();
	IIC_SDA=0;
		Delay(5);
	IIC_SCL=1;
		Delay(5);
	IIC_SCL=0;
}
	    
void IIC_NAck(void)
{
	IIC_SCL=0;
	SDA_OUT();
	IIC_SDA=1;
	
		Delay(5);
	IIC_SCL=1;
		Delay(5);
	IIC_SCL=0;
}					 				     
		  
void IIC_Send_Byte(u8 txd)
{                        
    u8 t; 
		SDA_OUT(); 	    
    IIC_SCL=0;
    for(t=0;t<8;t++)
    {              
        IIC_SDA=(txd&0x80)>>7;
        txd<<=1; 	  
			
		Delay(2);   
		IIC_SCL=1;
		Delay(5);
		IIC_SCL=0;	
		Delay(3);
    }	 
} 	 
  
u8 IIC_Read_Byte(unsigned char ack)
{
	unsigned char i,receive=0;
	SDA_IN();
    for(i=0;i<8;i++ )
	{
        IIC_SCL=0; 
        
		Delay(5);
		IIC_SCL=1;
        receive<<=1;
        if(READ_SDA)receive++;   
		
		Delay(5); 
    }					 
    if (ack)
        IIC_Ack(); 
    else
        IIC_NAck();
    return receive;
}

int32_t IICreadBytes(uint8_t dev, uint8_t reg, uint8_t *data, uint32_t length)
{
    uint32_t count = 0;

    IIC_Start();
    IIC_Send_Byte(dev);	
    if(IIC_Wait_Ack() == 1)return 0;
    IIC_Send_Byte(reg);
    if(IIC_Wait_Ack() == 1)return 0;
    IIC_Start();
    IIC_Send_Byte(dev+1); 
    if(IIC_Wait_Ack() == 1)return 0;

    for(count=0; count<length; count++)
    {
        if(count!=length-1)data[count]=IIC_Read_Byte(1);
        else  data[count]=IIC_Read_Byte(0);	 
    }
    IIC_Stop();
    return 1;
}


int32_t IICwriteBytes(uint8_t dev, uint8_t reg, uint8_t* data, uint32_t length)
{
    uint32_t count = 0;
    IIC_Start();
    IIC_Send_Byte(dev);	   
    if(IIC_Wait_Ack() == 1)return 0;
    IIC_Send_Byte(reg);   
    if(IIC_Wait_Ack() == 1)return 0;
    for(count=0; count<length; count++)
    {
        IIC_Send_Byte(data[count]);
        if(IIC_Wait_Ack() == 1)return 0;
    }
    IIC_Stop();

    return 1; 
}

/**
 * @brief  I2C写入函数（兼容接口）
 */
int i2cWrite(uint8_t addr, uint8_t reg, uint8_t len, uint8_t *data)
{
    return IICwriteBytes(addr << 1, reg, data, len);
}

/**
 * @brief  I2C读取函数（兼容接口）
 */
int i2cRead(uint8_t addr, uint8_t reg, uint8_t len, uint8_t *buf)
{
    return IICreadBytes(addr << 1, reg, buf, len);
}

/**
 * @brief  释放I2C总线（切换到其他I2C驱动前调用）
 * @note   将引脚设置为高电平，确保总线空闲
 */
void IIC_ReleaseBus(void)
{
    SDA_OUT();
    IIC_SDA = 1;
    IIC_SCL = 1;
    Delay(10);  // 等待总线稳定
}

/**
 * @brief  重新初始化IOI2C（从其他I2C驱动切换回来时调用）
 * @note   重新配置为推挽输出模式
 */
void IIC_ReInit(void)
{
    GPIO_InitTypeDef GPIO_InitStructure;
    GPIO_InitStructure.GPIO_Pin = GPIO_Pin_10 | GPIO_Pin_11;
    GPIO_InitStructure.GPIO_Mode = GPIO_Mode_Out_PP;       // 推挽输出
    GPIO_InitStructure.GPIO_Speed = GPIO_Speed_50MHz;
    GPIO_Init(GPIOB, &GPIO_InitStructure);
    
    SDA_OUT();
    IIC_SDA = 1;
    IIC_SCL = 1;
    Delay(5);
}
