2026-nuedc-d-land-air/DS-land-and-air/Hardware/bsp_gyro_wit.h

#ifndef __BSP_GYRO_WIT_H
#define __BSP_GYRO_WIT_H

#include "stm32f10x.h"

/* WIT/JY serial normal-protocol telemetry from USART2 remap (PD5/PD6). */
typedef struct
{
    int16_t rollTenthsDeg;
    int16_t pitchTenthsDeg;
    int16_t yawTenthsDeg;
    uint32_t validFrameCount;
    uint32_t angleFrameCount;
    uint32_t checksumErrorCount;
} GyroWitState_t;

void GyroWit_Init(uint32_t baudrate);
uint8_t GyroWit_Poll(void);
const GyroWitState_t *GyroWit_GetState(void);

#endif /* __BSP_GYRO_WIT_H */
