2026-nuedc-d-land-air/DS-land-and-air/Hardware/DHT11.h

#ifndef __DHT11_H
#define __DHT11_H
#include "stm32f10x.h"                  // Device header



#define dht11_high GPIO_SetBits(GPIOB, GPIO_Pin_12)
#define dht11_low GPIO_ResetBits(GPIOB, GPIO_Pin_12)
#define Read_Data GPIO_ReadInputDataBit(GPIOB, GPIO_Pin_12)

void DHT11_GPIO_Init_OUT(void);
void DHT11_GPIO_Init_IN(void);
void DHT11_Start(void);
unsigned char DHT11_REC_Byte(void);
void DHT11_REC_Data(void);

extern unsigned int rec_data[4];

#endif
