2026-nuedc-d-land-air/DS-land-and-air/Hardware/IOI2C.h

#ifndef __IOI2C_H
#define __IOI2C_H

#include "AllHeader.h"


#define SDA_IN()  {GPIOB->CRH&=0XFFFF0FFF;GPIOB->CRH|=8<<12;}
#define SDA_OUT() {GPIOB->CRH&=0XFFFF0FFF;GPIOB->CRH|=3<<12;}


#define IIC_SCL    PBout(10) //SCL
#define IIC_SDA    PBout(11) //SDA	 
#define READ_SDA   PBin(11)


//IIC所有操作函数	IIC all operation functions
void IIC_Init(void);				//初始化IIC引脚	Initialize IIC pins
void IIC_Start(void);				//发送IIC开始信号	Send IIC start signal
void IIC_Stop(void);	  			//发送IIC停止信号	Send IIC stop signal
void IIC_Send_Byte(u8 txd);			//IIC发送一个字节	IIC sends a byte
u8 IIC_Read_Byte(unsigned char ack);//IIC读取一个字节	IIC reads a byte
u8 IIC_Wait_Ack(void); 				//IIC等待ACK信号		IIC waits for ACK signal
void IIC_Ack(void);					//IIC发送ACK信号		IIC sends ACK signal
void IIC_NAck(void);				//IIC不发送ACK信号	IIC does not send ACK signal

int i2cWrite(uint8_t addr, uint8_t reg, uint8_t len, uint8_t *data);
int i2cRead(uint8_t addr, uint8_t reg, uint8_t len, uint8_t *buf);

void IIC_ReleaseBus(void);   // 释放I2C总线（切换前调用）
void IIC_ReInit(void);       // 重新初始化IOI2C（切换回来时调用）

#endif

//------------------End of File----------------------------
