2026-nuedc-d-land-air/DS-land-and-air/Hardware/bsp.c

#include "bsp.h"
void BSP_init(void)
{
	SystemInit();
	NVIC_PriorityGroupConfig(NVIC_PriorityGroup_2); 
	
	
	delay_init();

	
	
	USART1_init(115200);
	USART2_init(115200);
	
	Motor_Init();
	Motor_Enable(1);


	RCC_APB2PeriphClockCmd(RCC_APB2Periph_AFIO, ENABLE);
	GPIO_PinRemapConfig(GPIO_Remap_SWJ_JTAGDisable, ENABLE);
	
	
}
