2026-nuedc-d-land-air/DS-land-and-air/Hardware/bsp_timer.c

/**
 * @file bsp_timer.c
 * @brief TIM4 定时器驱动 (已废弃 - 2026/01/16)
 * @note 此文件已不再使用，精确计时功能已迁移到 bsp_systick.c (使用TIM2)
 *       保留此文件以备将来需要10us级别延时时使用
 */

#include "bsp_timer.h"

#if 0  // ========== 以下代码已废弃，不再编译 ==========

u16 timer_delay_cnt = 0;

void my_delay_10ms(u16 time)
{
	timer_delay_cnt = time;
	while(timer_delay_cnt != 0);
}

/**************************************************************************
功能：TIM4初始化，定时10us
**************************************************************************/
void TIM4_Init(void)
{
	TIM_TimeBaseInitTypeDef TIM_TimeBaseStructure;
	NVIC_InitTypeDef NVIC_InitStructure;
	RCC_APB1PeriphClockCmd(RCC_APB1Periph_TIM4, ENABLE);
	TIM_TimeBaseStructure.TIM_Prescaler = 71;
	TIM_TimeBaseStructure.TIM_Period = 9;
	TIM_TimeBaseInit(TIM4, &TIM_TimeBaseStructure);
	TIM_ClearFlag(TIM4, TIM_FLAG_Update);
	TIM_ITConfig(TIM4, TIM_IT_Update, ENABLE);

	NVIC_InitStructure.NVIC_IRQChannel = TIM4_IRQn;
	NVIC_InitStructure.NVIC_IRQChannelPreemptionPriority = 1;
	NVIC_InitStructure.NVIC_IRQChannelSubPriority = 1;
	NVIC_InitStructure.NVIC_IRQChannelCmd = ENABLE;
	NVIC_Init(&NVIC_InitStructure);

	TIM_Cmd(TIM4, ENABLE);
}

void TIM4_IRQHandler(void)
{
	if (TIM_GetITStatus(TIM4, TIM_IT_Update) != RESET)
	{
		TIM_ClearITPendingBit(TIM4, TIM_IT_Update);
	}
}

#endif // ========== 废弃代码结束 ==========
