2026-nuedc-d-land-air/DS-land-and-air/Hardware/bsp_usart.h

#ifndef __BSP_USART_H
#define __BSP_USART_H

#include "AllHeader.h"


void USART1_init(u32 baudrate);
void USART1_Send_ArrayU8(uint8_t *BufferPtr, uint16_t Length);
void USART1_Send_U8(uint8_t ch);


void USART2_init(u32 baudrate);
void USART2_Send_ArrayU8(uint8_t *BufferPtr, uint16_t Length);
void USART2_Send_U8(uint8_t ch);

/* UART4 (PC10/PC11) - 用于日志导出（DAPLink） */
void UART4_init(u32 baudrate);
void UART4_Send_U8(uint8_t ch);
void UART4_Send_ArrayU8(uint8_t *BufferPtr, uint16_t Length);
void UART4_Send_String(const char *str);

#endif
