2026-nuedc-d-land-air/DS-land-and-air/Hardware/app_servo_test.h

#ifndef __APP_SERVO_TEST_H
#define __APP_SERVO_TEST_H

#include "stm32f10x.h"

void ServoTest_Init(void);
void ServoTest_StopAll(void);
uint8_t ServoTest_IsActionCommand(uint8_t command);
const char *ServoTest_GetActionName(uint8_t command);
uint32_t ServoTest_GetMoveTimeMs(void);
uint32_t ServoTest_GetFrameGapMs(void);
void ServoTest_HandleCommand(char source, uint8_t command);
void ServoTest_PollServoResponse(void);
void ServoTest_LogNanoByte(uint8_t byte);

#endif /* __APP_SERVO_TEST_H */
