2026-nuedc-d-land-air/DS-land-and-air/(commit log)

2026-07-13 checkpoint: verify four-wheel motor directions
2026-07-14 feat(lidar-car): add Nano UART and Bluetooth motor test firmware
    [bluetooth_mecanum_test_template_20260713.csv, front_reverse_order_driver_fail_20260712.csv, front_static_enable_driver_chain_fail_20260712.csv, front_test_20260712_164517.csv, front_test_idr_20260712.csv, left_rear_reverse_fail_20260712.csv, pe8_pe9_swap_fault_stays_pe8_20260712.csv, rear_pin_isolation_repeat3_20260712.csv]
2026-07-15 feat(lidar-car): add bluetooth arm control and gyro diagnostics
2026-07-15 backup(lidar-car): add 3d models and nano workspace
    [10mm铜柱.SLDPRT, 60mm铜柱.SLDPRT, DG_130.stp.sldprt, DUOPAN-DG.stp.sldprt, DUOPAN-SG.stp.sldprt, GE_57.stp.sldprt, Jason固定架.SLDPRT, Jason固定架.STL]
2026-07-29 checkpoint: motor pcb and workspace baseline 20260729
2026-07-29 test: add four-wheel TB6612 bring-up
